pedrominatel/minatel-kicad-libraries/README.md

# KiCad Libraries for Makers!

KiCad Libraries for maker projects.

Use at your own risk!

## LCSC components libraries

git clone --recurse-submodules git@github.com:pedrominatel/minatel-kicad-libraries.git

### Connectors
#### USB Type C
 	U262-161N-4BVC11 - C319148 (https://lcsc.com/product-detail/USB-Connectors_XKB-Enterprise-U262-16XN-4BVC11_C319148.html)

## Maker boards libraries

## Espressif Library

Chip | Version | Footprint
--- | --- | ---
ESP32-S2 | v1 | QFN-56
