pedrominatel/minatel-kicad-libraries/003_3d/ICM-42670-P.step

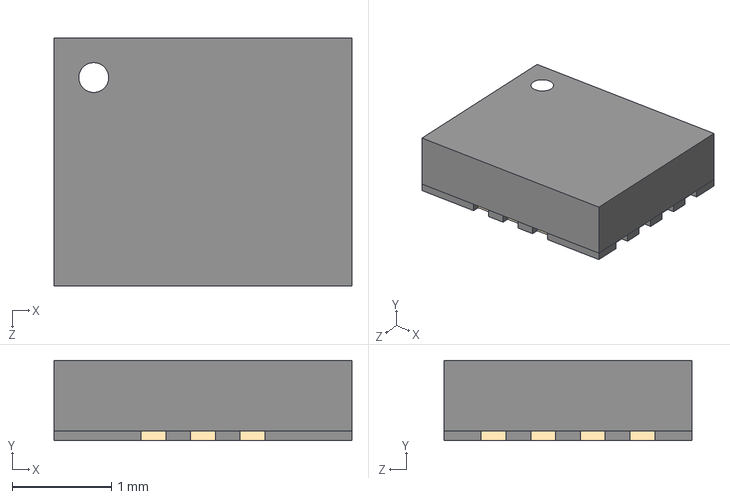
[picture p1: CAD file, 2022-03-09]
003_3d/ICM-42670-P.step
3.00 x 0.81 x 2.50 mm
