pedrominatel/minatel-kicad-libraries/003_3d/SCD40-D-R2.STEP

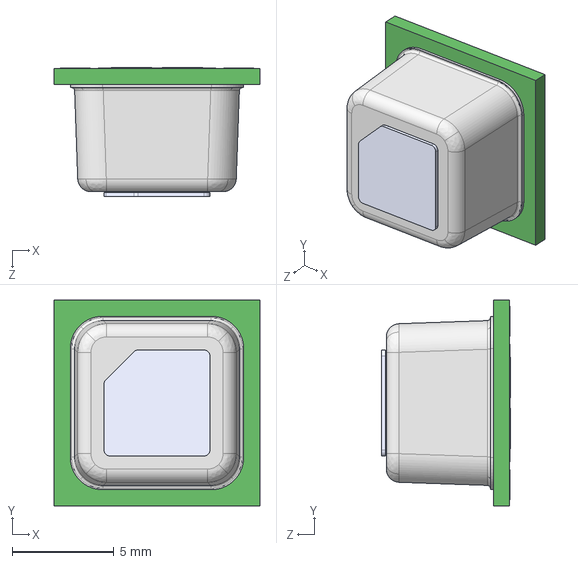
[picture p2: CAD file, 2022-03-09]
003_3d/SCD40-D-R2.STEP
10.1 x 10.1 x 6.31 mm
