pedrominatel/minatel-kicad-libraries/003_3d/USB4105-GF-A.step

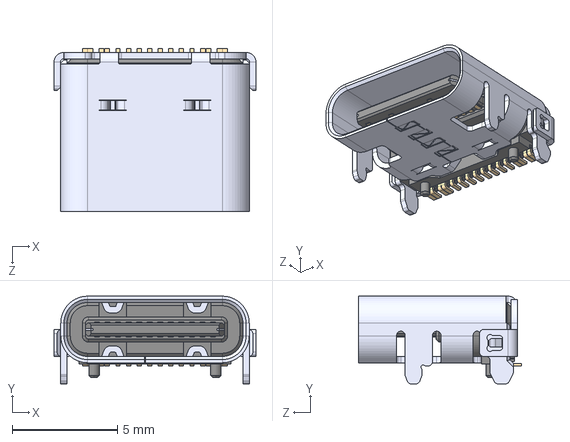
[picture p3: CAD file, 2022-03-09]
003_3d/USB4105-GF-A.step
9.58 x 4.16 x 7.71 mm
