pedrominatel/minatel-kicad-libraries/003_3d/SHTC3.step

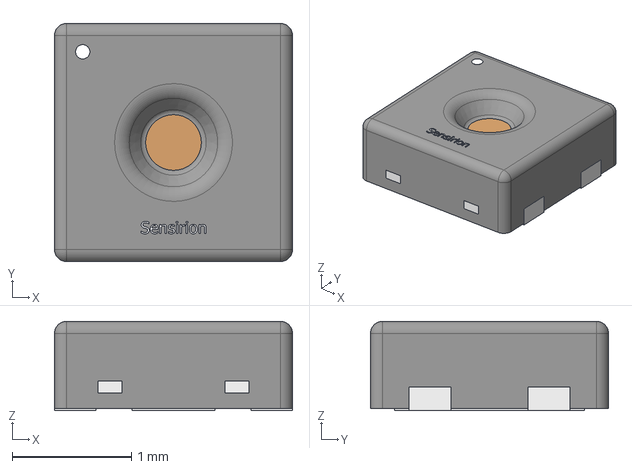
[picture p4: CAD file, 2022-03-09]
003_3d/SHTC3.step
2.00 x 2.00 x 0.751 mm
