pedrominatel/minatel-kicad-libraries/003_3d/CLA1B-WKW-XD0F0DZ3.STEP

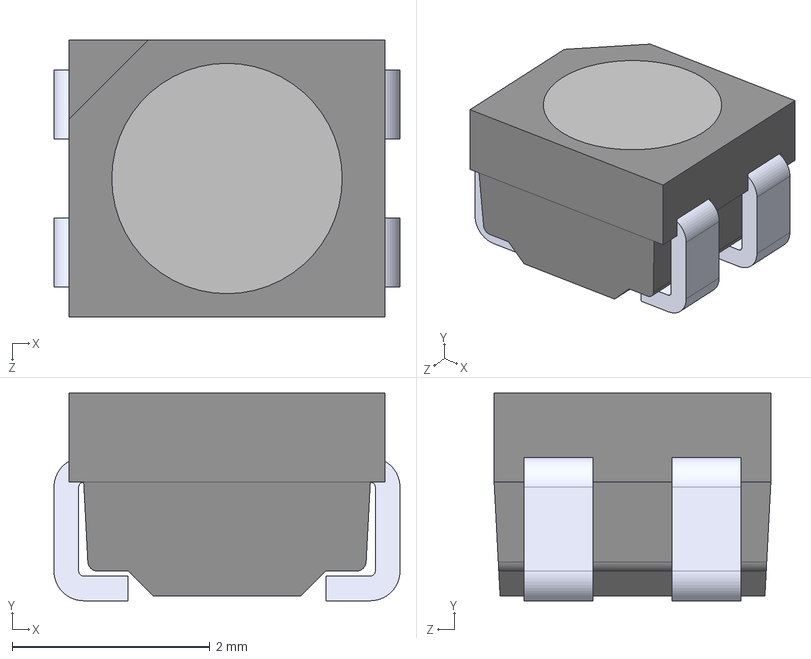
[picture p5: CAD file, 2021-02-21]
003_3d/CLA1B-WKW-XD0F0DZ3.STEP
3.50 x 2.10 x 2.80 mm
