pedrominatel/minatel-kicad-libraries/003_3d/MLL1200S--3DModel-STEP-56544.STEP

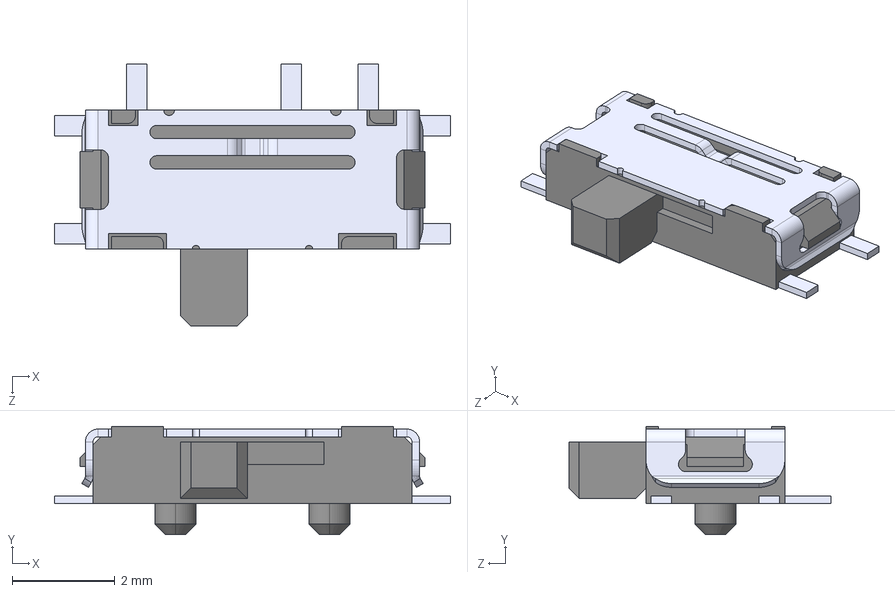
[picture p6: CAD file, 2021-02-21]
003_3d/MLL1200S--3DModel-STEP-56544.STEP
7.70 x 2.10 x 5.10 mm
