pedrominatel/minatel-kicad-libraries/003_3d/74HC1G32GW,125.stp

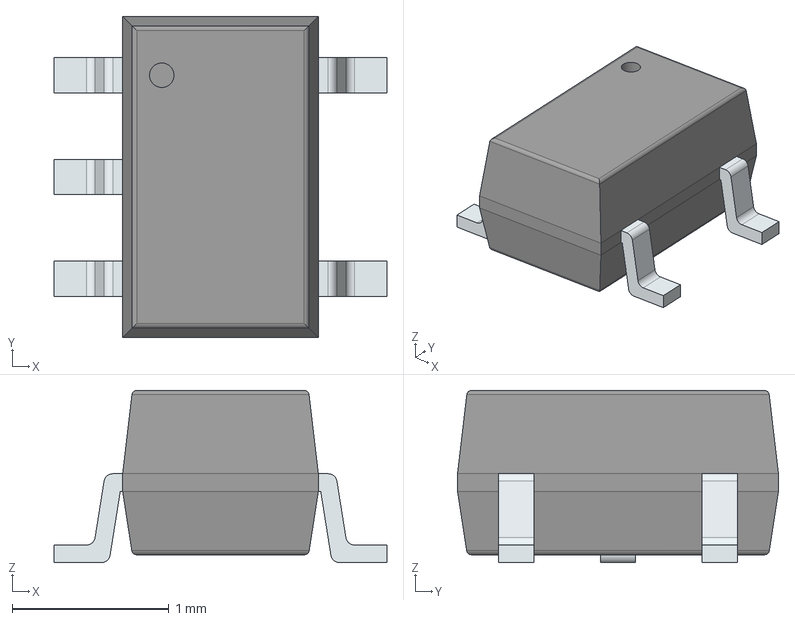
[picture p7: CAD file, 2021-02-21]
003_3d/74HC1G32GW,125.stp
2.12 x 2.05 x 1.10 mm
PinsArrayL
PinsArrayR
