pedrominatel/minatel-kicad-libraries/003_3d/PTS636 SM43J SMTR LFS--3DModel-STEP-56544.STEP

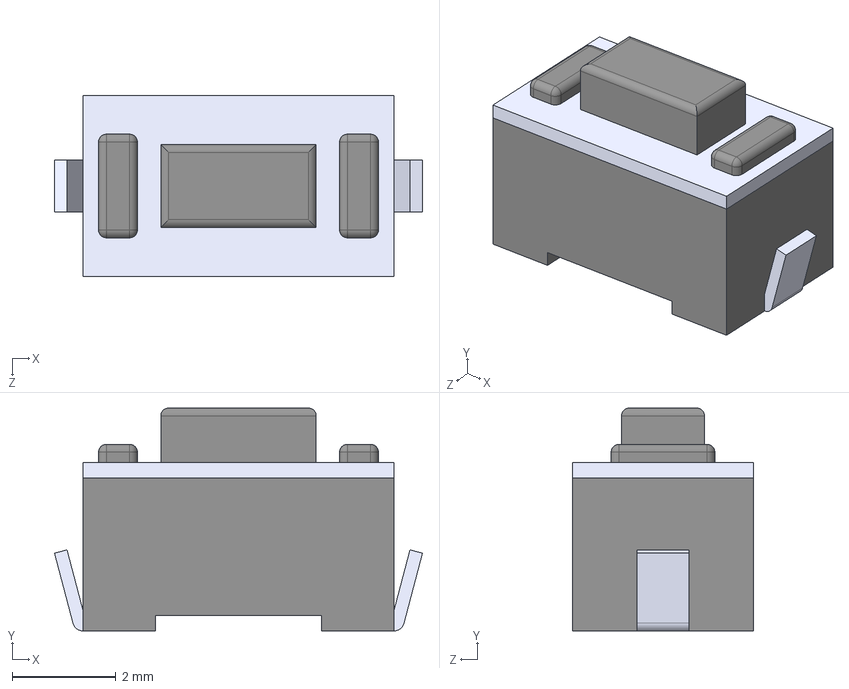
[picture p8: CAD file, 2021-02-21]
003_3d/PTS636 SM43J SMTR LFS--3DModel-STEP-56544.STEP
7.10 x 4.30 x 3.50 mm
