pedrominatel/minatel-kicad-libraries/003_3d/SKRPACE010.stp

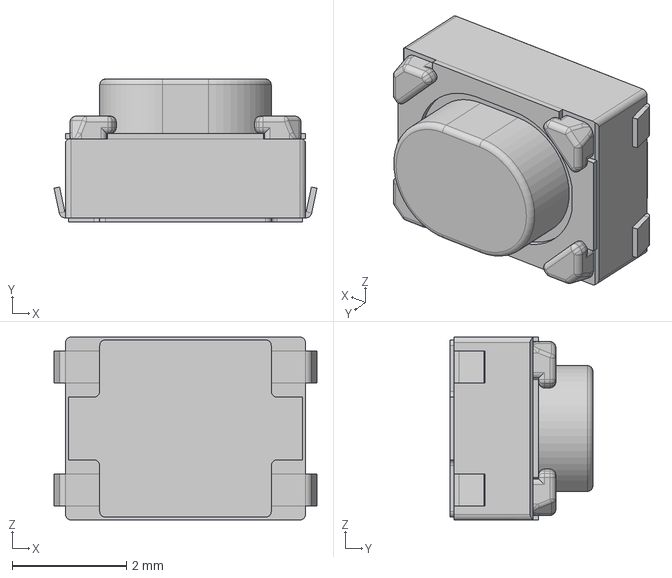
[picture p9: CAD file, 2021-02-21]
003_3d/SKRPACE010.stp
4.60 x 2.50 x 3.20 mm
