pedrominatel/minatel-kicad-libraries/003_3d/CUI_SJ-3524-SMT-TR.STEP

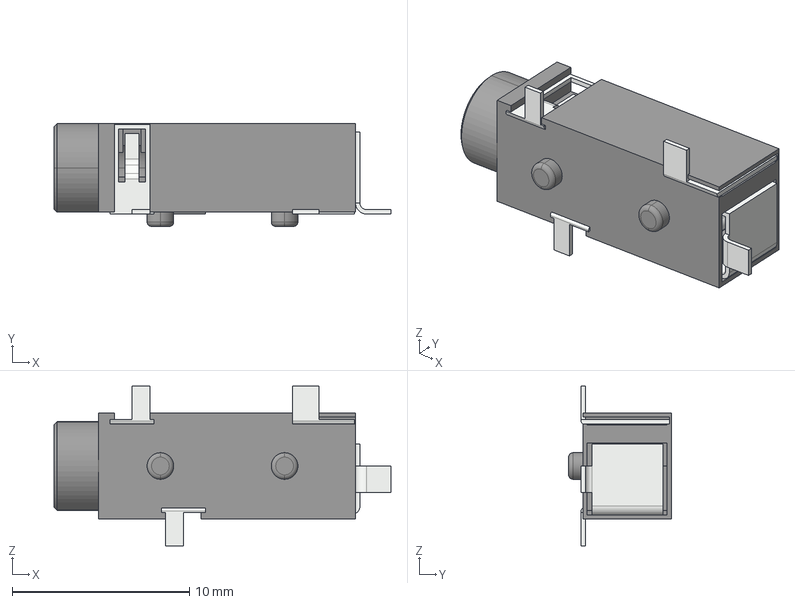
[picture p10: CAD file, 2021-02-21]
003_3d/CUI_SJ-3524-SMT-TR.STEP
19.0 x 5.80 x 9.00 mm
