pedrominatel/minatel-kicad-libraries/003_3d/omega2s_rf_cover.step

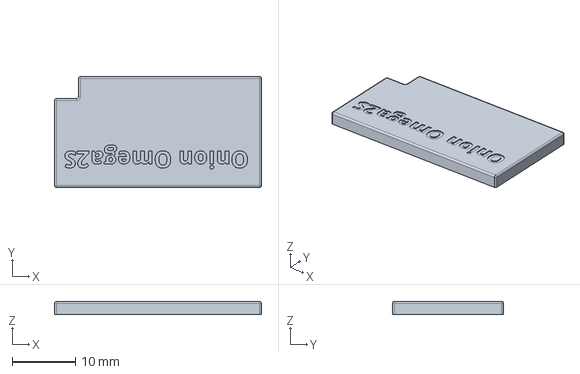
[picture p11: CAD file, 2021-02-21]
003_3d/omega2s_rf_cover.step
32.8 x 17.6 x 2.10 mm
