pedrominatel/minatel-kicad-libraries/003_3d/PTS526_SM08_SMTR2_LFS.step

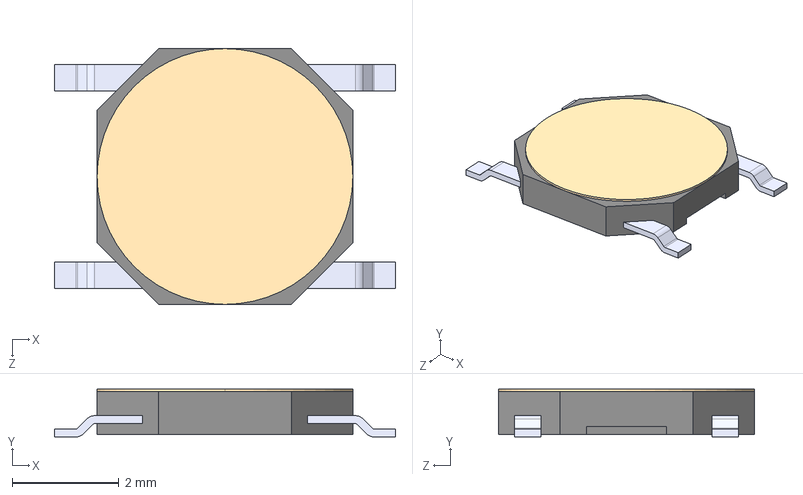
[picture p12: CAD file, 2021-02-21]
003_3d/PTS526_SM08_SMTR2_LFS.step
6.40 x 0.9 x 4.80 mm
