pedrominatel/minatel-kicad-libraries/003_3d/SPH0641LM4H-1--3DModel-STEP-56544.STEP

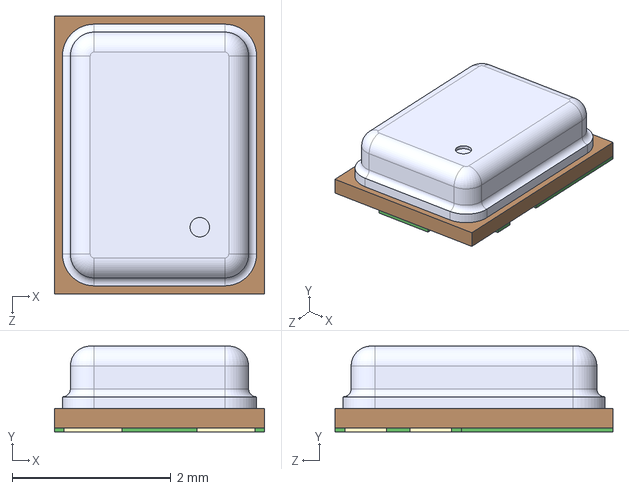
[picture p13: CAD file, 2021-02-21]
003_3d/SPH0641LM4H-1--3DModel-STEP-56544.STEP
2.65 x 1.08 x 3.50 mm
