pedrominatel/minatel-kicad-libraries/003_3d/FR01-S4-210.step

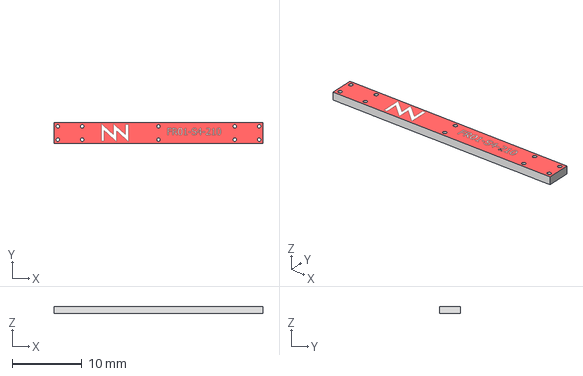
[picture p14: CAD file, 2021-02-21]
003_3d/FR01-S4-210.step
30.0 x 3.00 x 1.01 mm
