pedrominatel/minatel-kicad-libraries/003_3d/1-1734028-1.stp

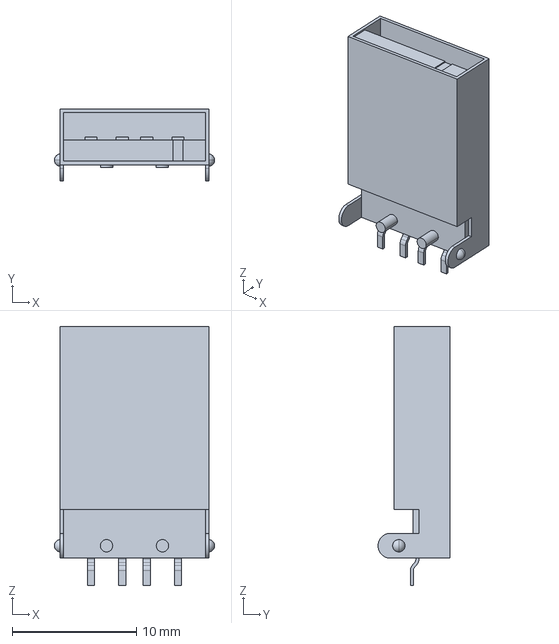
[picture p15: CAD file, 2021-02-21]
003_3d/1-1734028-1.stp
12.9 x 5.80 x 20.9 mm
