pedrominatel/minatel-kicad-libraries/003_3d/PTS815_SJM_250_SMTR_LFS.stp

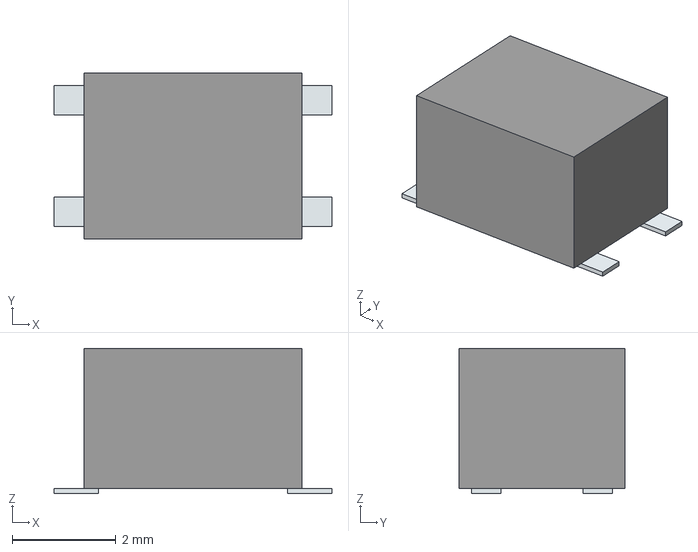
[picture p16: CAD file, 2021-02-21]
003_3d/PTS815_SJM_250_SMTR_LFS.stp
5.36 x 3.20 x 2.80 mm
Pins
