pedrominatel/minatel-kicad-libraries/003_3d/omega2s_cad.step

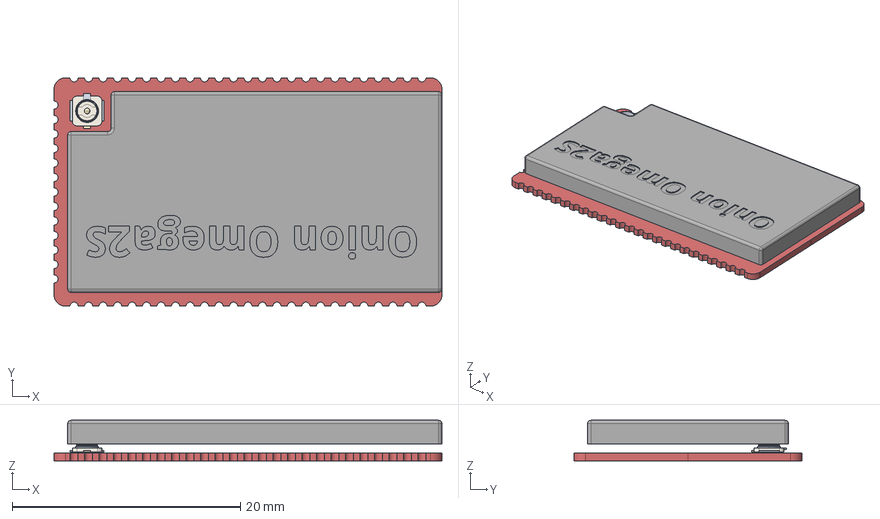
[picture p17: CAD file, 2021-02-21]
003_3d/omega2s_cad.step
34.0 x 20.0 x 3.55 mm
