pedrominatel/minatel-kicad-libraries/003_3d/PTS810SJK250SMTRLFS.step

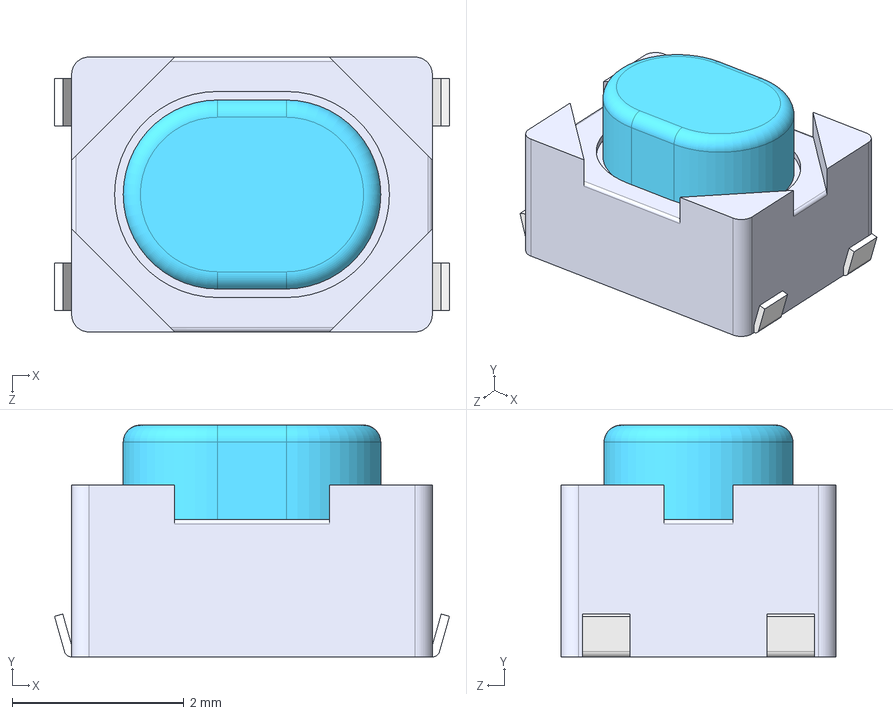
[picture p18: CAD file, 2021-02-21]
003_3d/PTS810SJK250SMTRLFS.step
4.60 x 2.70 x 3.20 mm
