pedrominatel/minatel-kicad-libraries/003_3d/keystone-PN2468.STEP

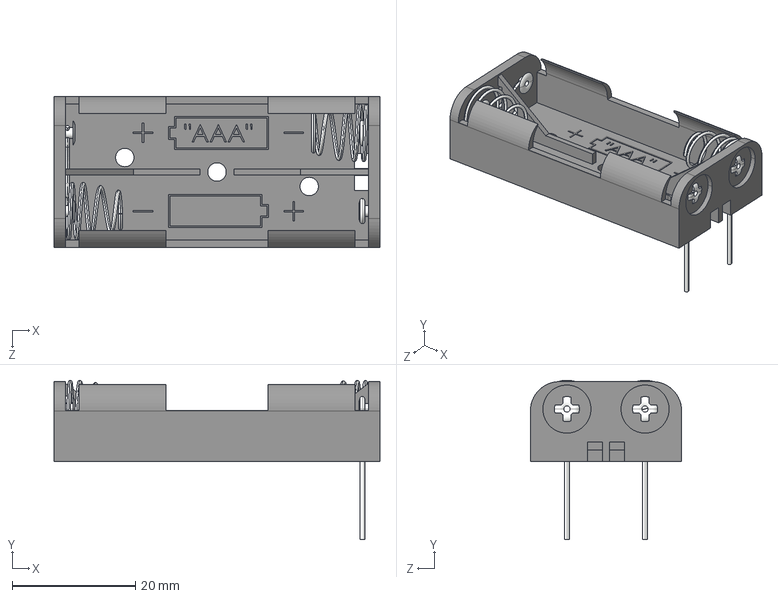
[picture p19: CAD file, 2021-02-21]
003_3d/keystone-PN2468.STEP
53.0 x 25.9 x 24.6 mm
