pedrominatel/minatel-kicad-libraries/003_3d/ANT3216LL00R2400A.stp

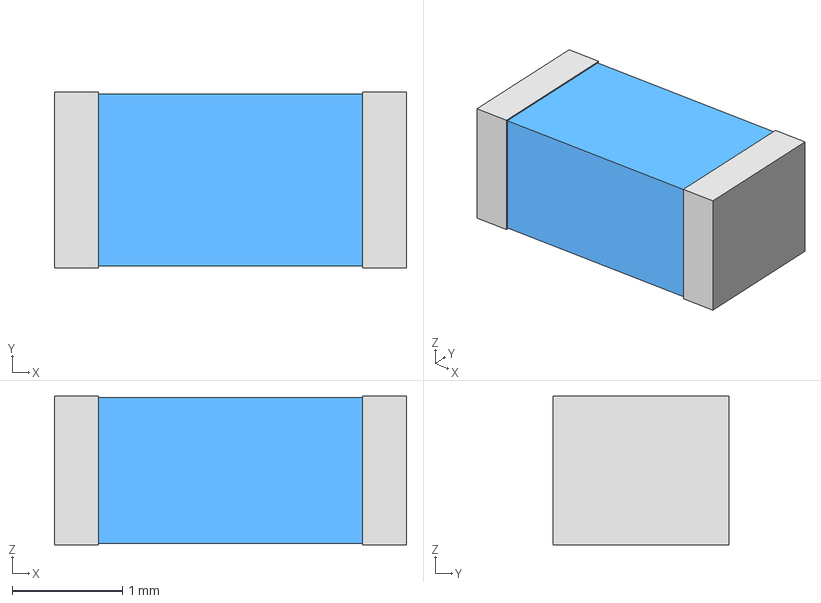
[picture p20: CAD file, 2021-02-21]
003_3d/ANT3216LL00R2400A.stp
3.20 x 1.60 x 1.35 mm
term1
term2
