pedrominatel/minatel-kicad-libraries/(list of files, cad)

Other CAD files:
003_3d/104224-0820.step
003_3d/146235-0001.step
003_3d/1909763-1.step
003_3d/74HC1G32GW,125.stl
003_3d/78646-3001.step
003_3d/ANT3216LL00R2400A.stl
003_3d/PTS815_SJM_250_SMTR_LFS.stl
003_3d/TPS62291DRVR.step
