pedrominatel/minatel-kicad-libraries/(commit log)

2020-03-14 Added KiCad libraries
2020-07-26 Added ESP32-S2 library
2021-02-21 Reorg on the libs folders and structure
    [1-1734028-1.stp, 104224-0820.step, 146235-0001.step, 74HC1G32GW,125.stl, 74HC1G32GW,125.stp, ANT3216LL00R2400A.stl, ANT3216LL00R2400A.stp, CLA1B-WKW-XD0F0DZ3.STEP]
2021-12-12 Added new libs
    [1909763-1.step, 78646-3001.step]
2022-03-09 Added MICS sensors SYM
2022-03-09 Added more parts
    [ICM-42670-P.step, PTS810SJK250SMTRLFS.step, SCD40-D-R2.STEP, SHTC3.step, USB4105-GF-A.step]
